DmitryTyazhlov/IR_iButton/hardware/PCB_3D_bottom_layer.png

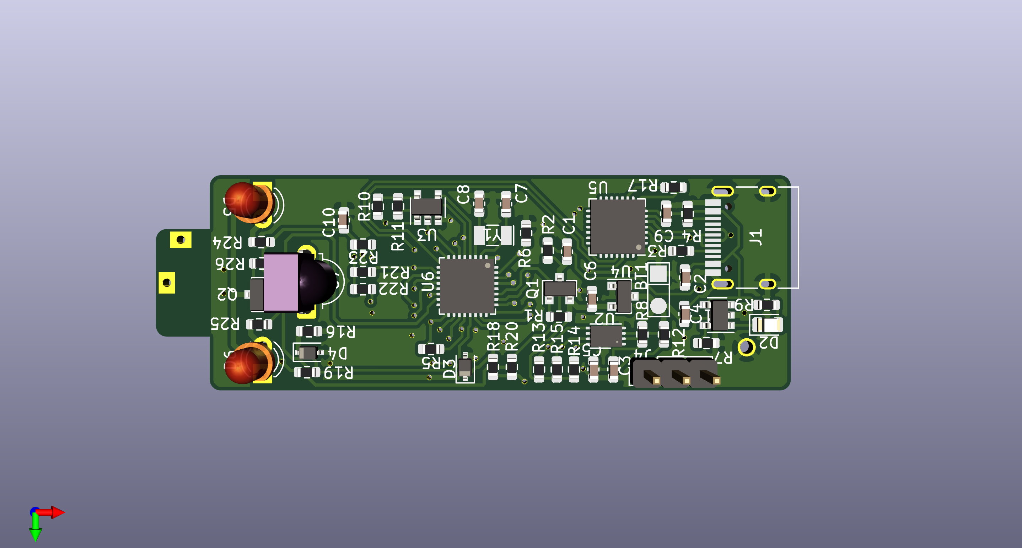
hardware/PCB_3D_bottom_layer.png
