DmitryTyazhlov/IR_iButton/hardware/PCB_3D_top_layer.png

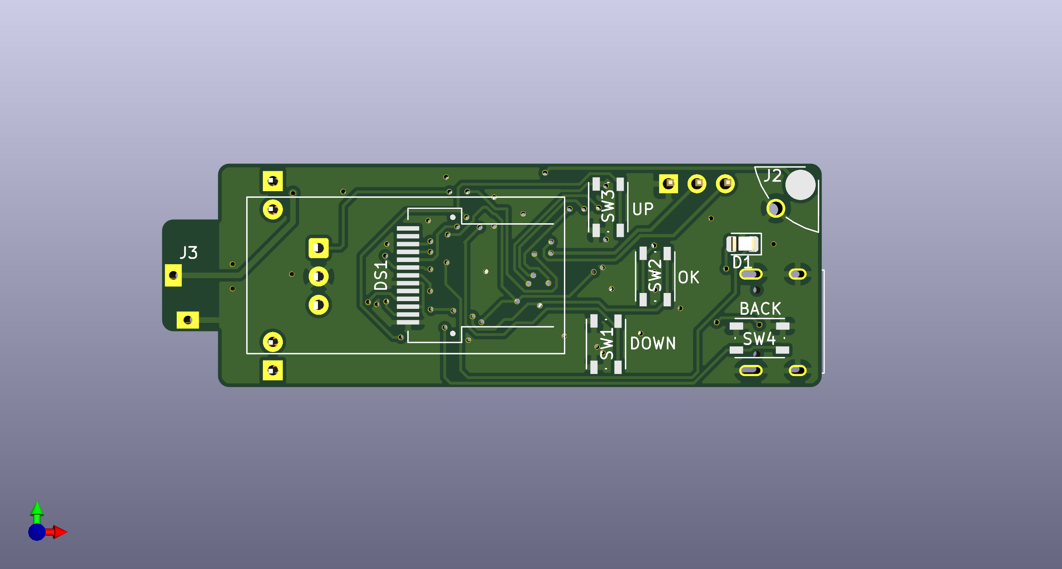
hardware/PCB_3D_top_layer.png
