DmitryTyazhlov/IR_iButton/docs/2021-11-05 23.26.21.jpg

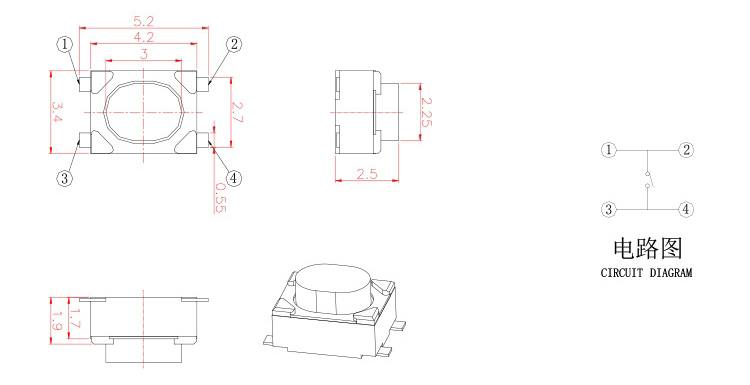
docs/2021-11-05 23.26.21.jpg
