DmitryTyazhlov/IR_iButton/docs/H74ff0cd74b204db1b7edd1876542bb8cC.png

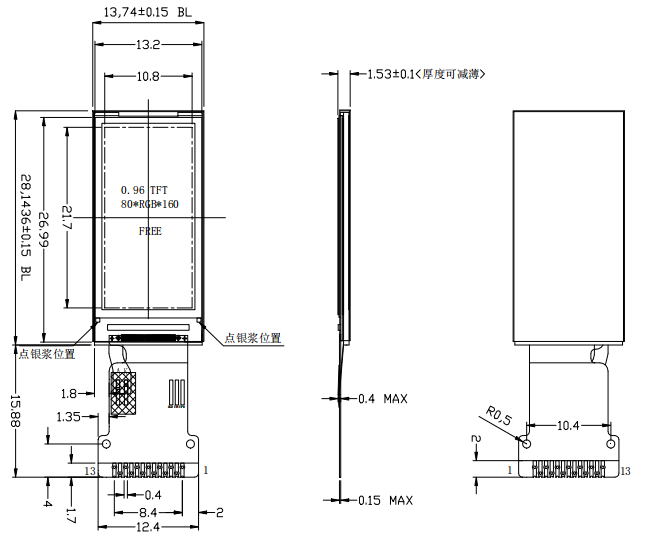
docs/H74ff0cd74b204db1b7edd1876542bb8cC.png
