DmitryTyazhlov/IR_iButton/docs/HTB19O_NNxjaK1RjSZKzq6xVwXXa3.webp

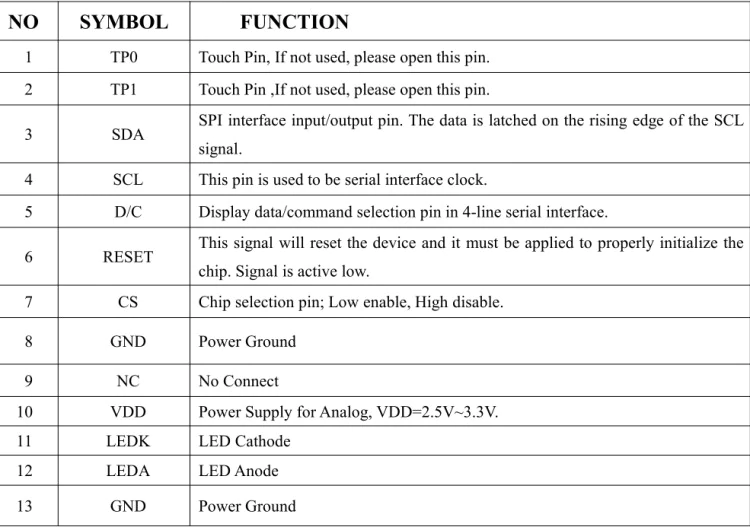
docs/HTB19O_NNxjaK1RjSZKzq6xVwXXa3.webp
