DmitryTyazhlov/IR_iButton/hardware/PCB_size.pdf

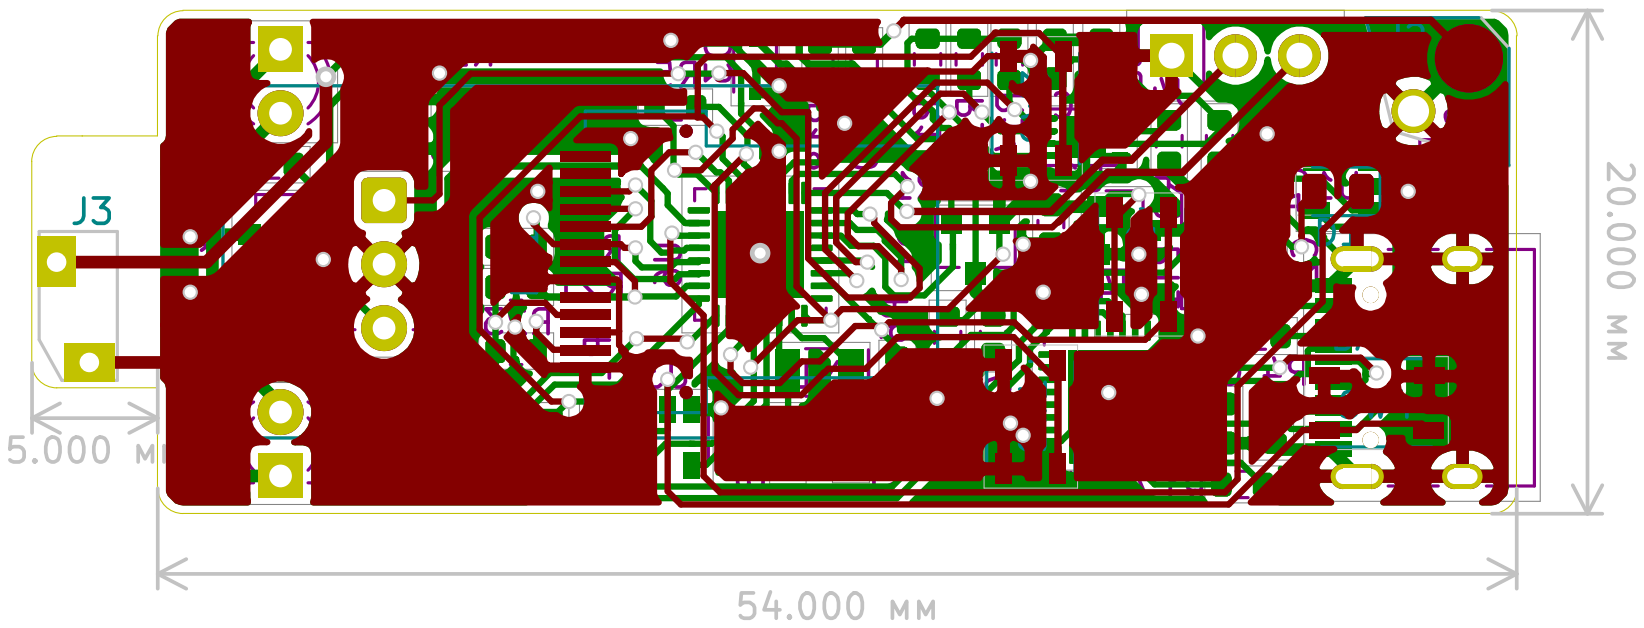
[picture p6: page 1]
