DmitryTyazhlov/IR_iButton/hardware/Scheme.pdf

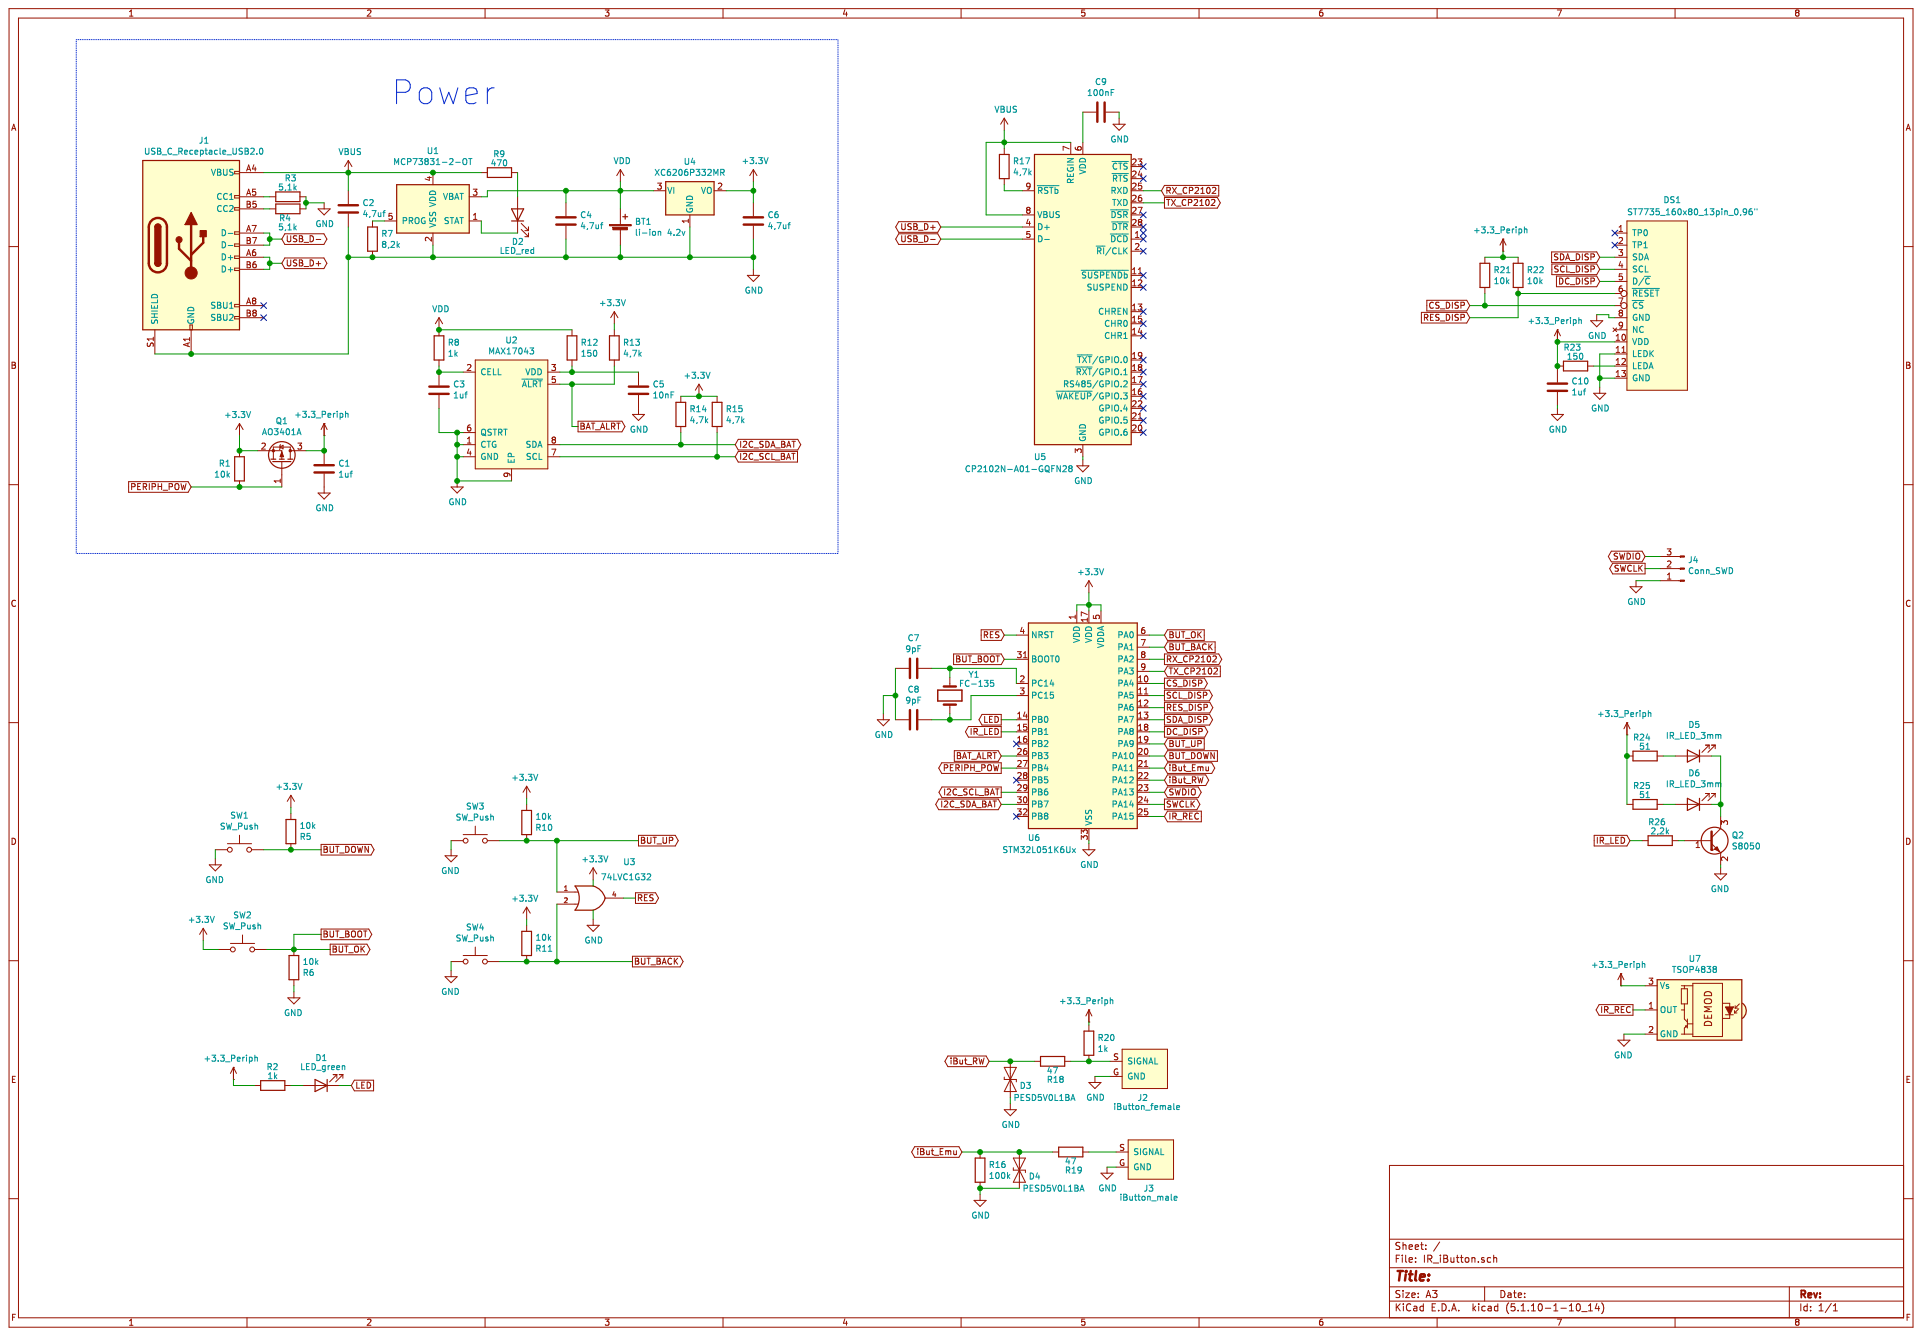
[picture p7: page 1]
