DmitryTyazhlov/IR_iButton/hardware/IR_iButton/IR_iButton.sch

## KiCad design hardware/IR_iButton/IR_iButton.sch (2021-12-14)

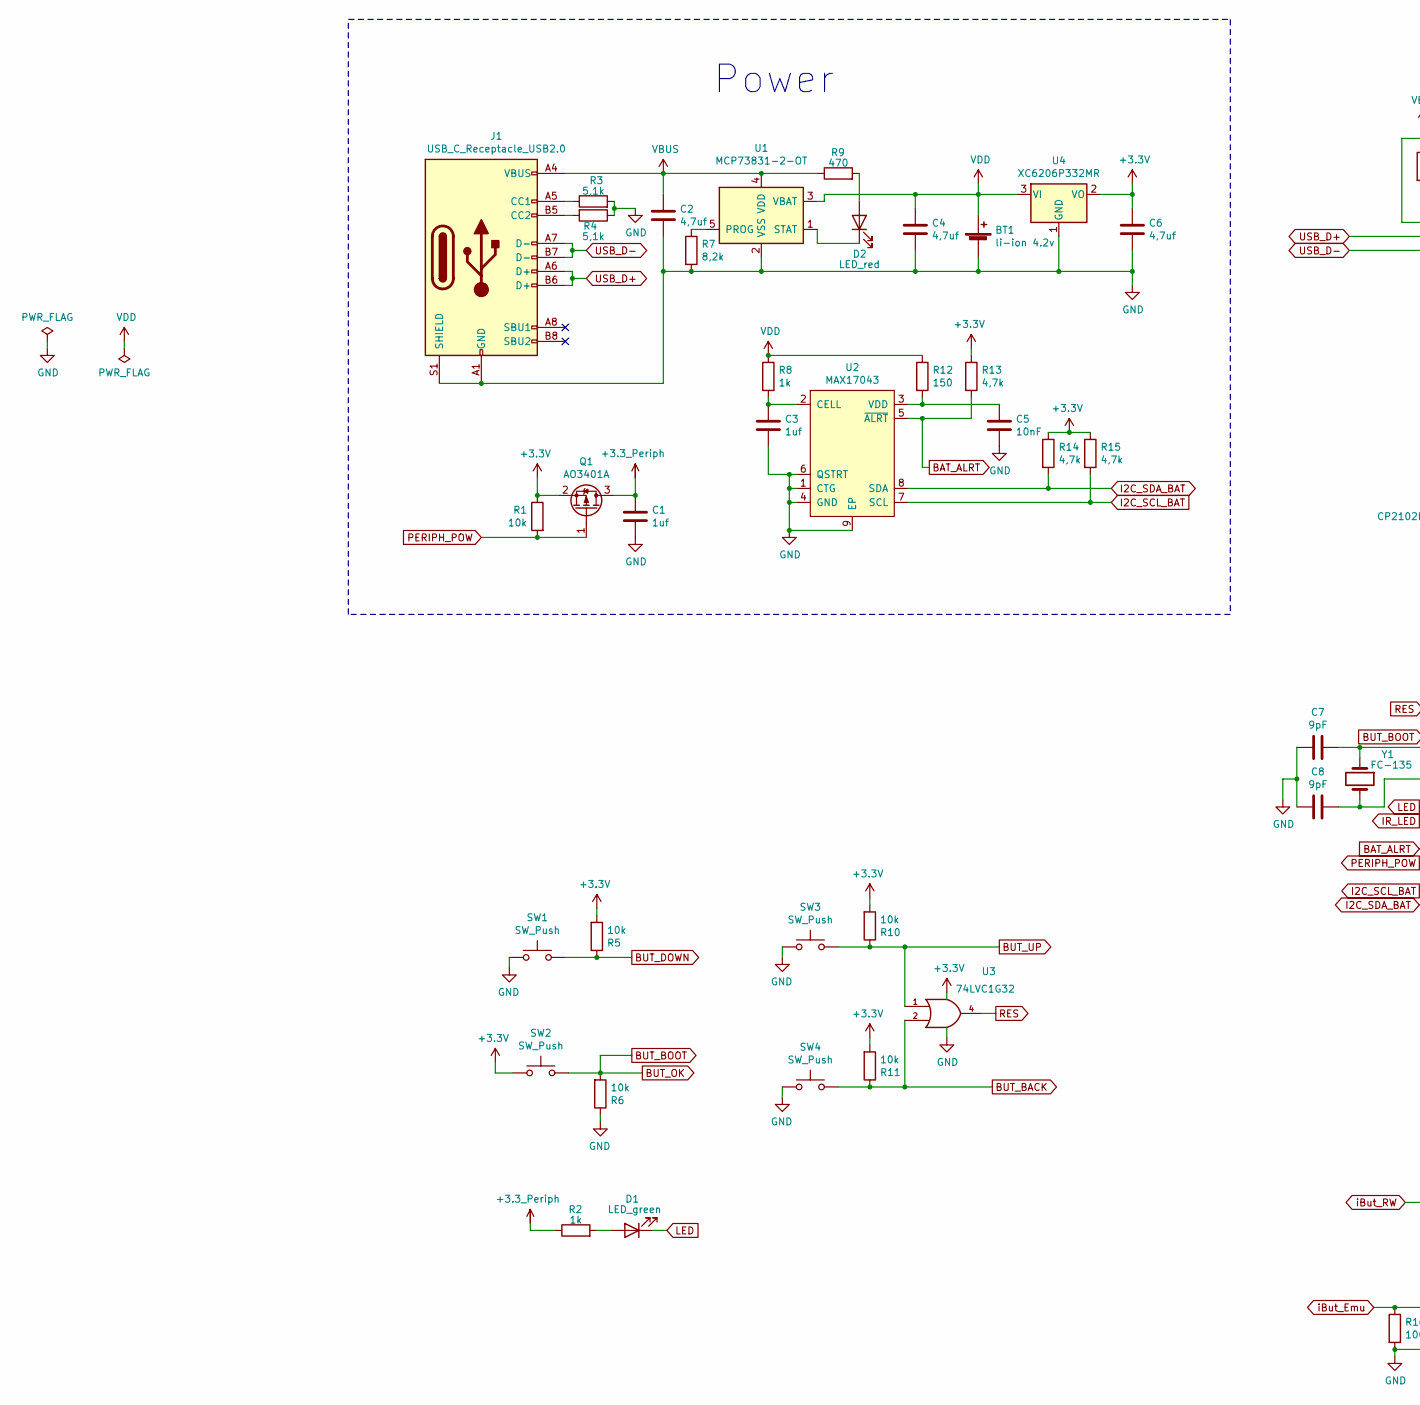
[picture p8: schematic IR_iButton.sch, part in row 2, column 1]

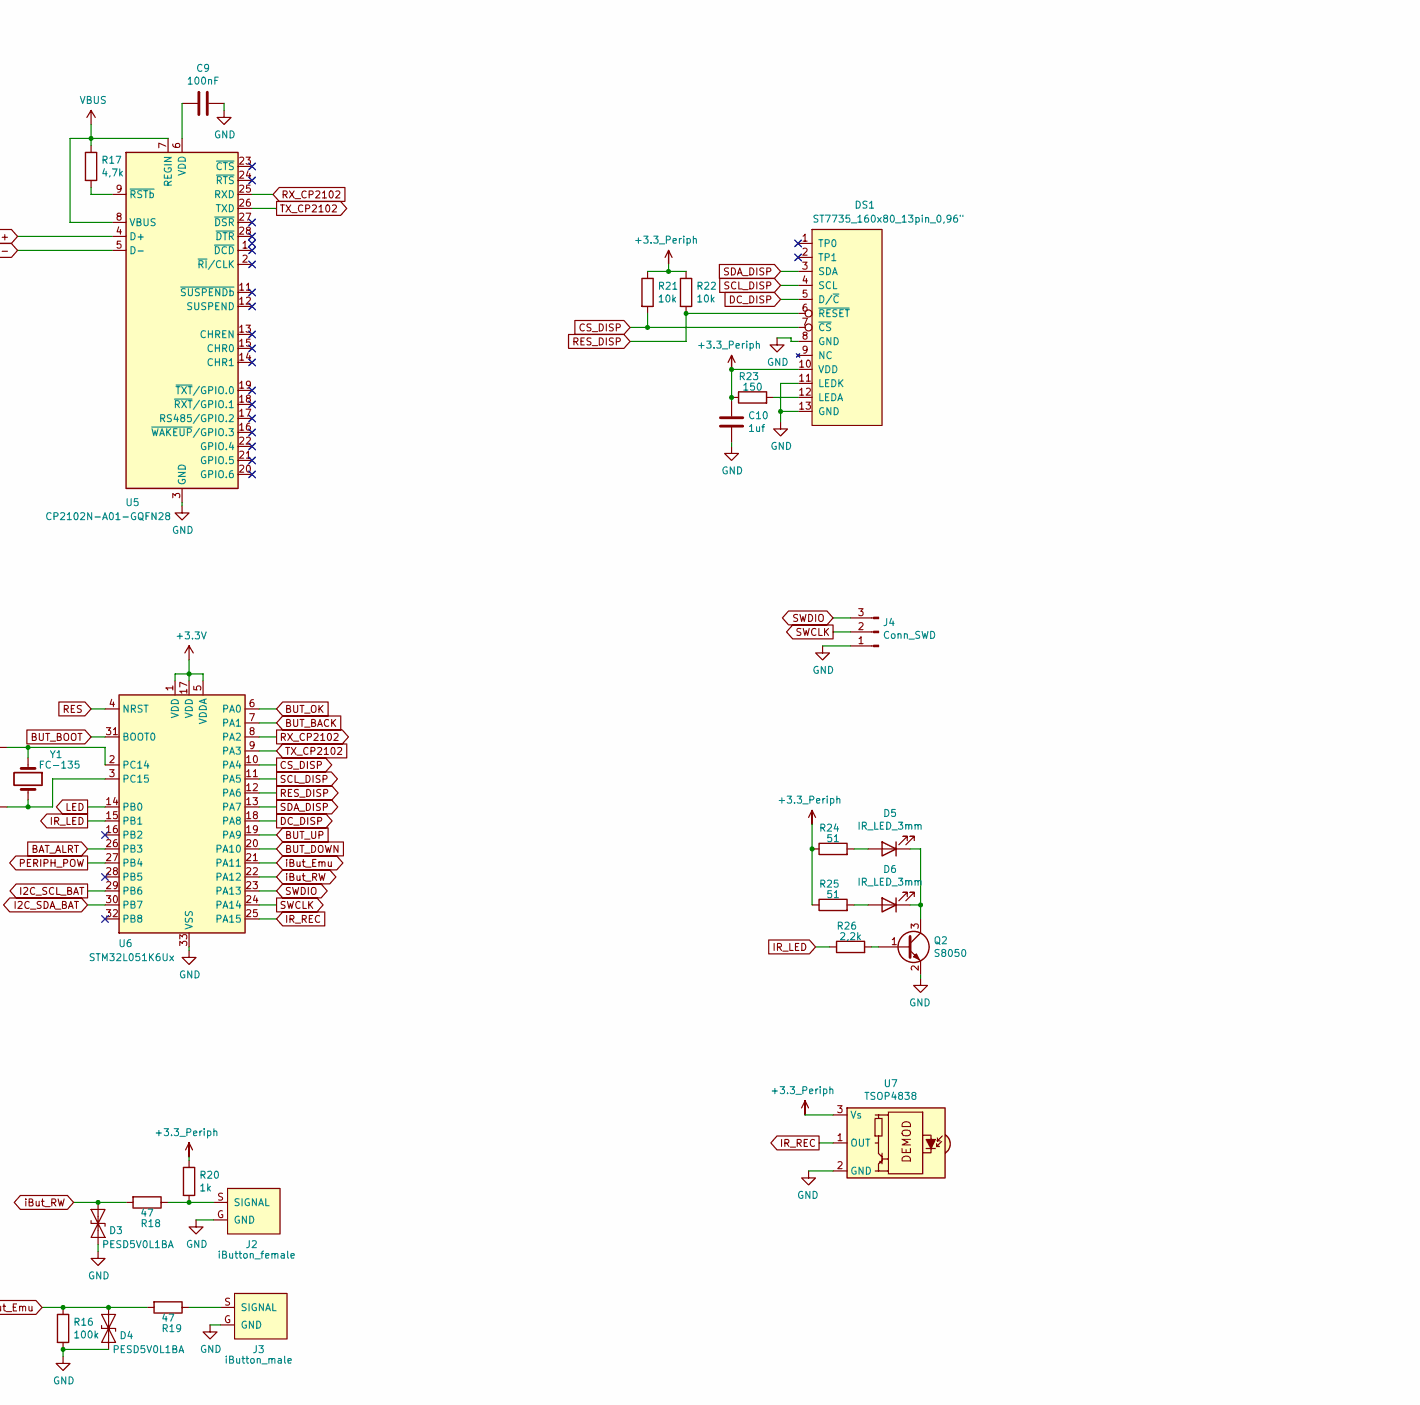
[picture p9: schematic IR_iButton.sch, part in row 2, column 2]

Parts:
BT1: li-ion 4.2v; Battery_smd
C1, C3, C10: 1uf; C_0603_1608Metric
C2, C4, C6: 4,7uf; C_0603_1608Metric
C5: 10nF; C_0603_1608Metric
C7, C8: 9pF; C_0603_1608Metric
C9: 100nF; C_0603_1608Metric
D1: LED_green; LED_0805_2012Metric
D2: LED_red; LED_0805_2012Metric
D3, D4: PESD5V0L1BA; D_SOD-323
D5, D6: IR_LED_3mm; LED_D3.0mm
DS1: ST7735_160x80_13pin_0,96\"; ST7735_160x80_0,96''_TOP
J1: USB_C_Receptacle_USB2.0; USB_C_Receptacle_HRO_TYPE-C-31-M-12
J2: iButton_female
J3: iButton_male
J4: Conn_SWD; PinHeader_1x03_P2.54mm_Vertical
Q1: AO3401A; SOT-23
Q2: S8050; SOT-23
R1, R5, R6, R10, R11, R21, R22: 10k; R_0603_1608Metric
R2, R8, R20: 1k; R_0603_1608Metric
R3, R4: 5,1k; R_0603_1608Metric
R7: 8,2k; R_0603_1608Metric
R9: 470; R_0603_1608Metric
R12, R23: 150; R_0603_1608Metric
R13, R14, R15, R17: 4,7k; R_0603_1608Metric
R16: 100k; R_0603_1608Metric
R18, R19: 47; R_0603_1608Metric
R24, R25: 51; R_0603_1608Metric
R26: 2,2k; R_0603_1608Metric
SW1, SW2, SW3, SW4: SW_Push; SW_Push_1P1T_NO_Vertical_Wuerth_434133025816
U1: MCP73831-2-OT; SOT-23-5
U2: MAX17043; TDFN-8-1EP_3x2mm_P0.5mm_EP1.80x1.65mm
U3: 74LVC1G32; SOT-23-5
U4: XC6206P332MR; SOT-23
U5: CP2102N-A01-GQFN28; QFN-28-1EP_5x5mm_P0.5mm_EP3.35x3.35mm
U6: STM32L051K6Ux; QFN-32-1EP_5x5mm_P0.5mm_EP3.45x3.45mm
U7: TSOP4838; Vishay_MINICAST-3Pin
Y1: FC-135; Crystal_SMD_EuroQuartz_EQ161-2Pin_3.2x1.5mm

Connections:
+3.3V: C6.2, Q1.2 (S), R1.1, R5.2, R10.2, R11.2, R13.1, R14.1, R15.1, SW2.1, U3.5 (VCC), U4.2 (VO), U6.1 (VDD), U6.5 (VDDA), U6.17 (VDD)
+3.3_Periph: C1.1, C10.2, DS1.10 (VDD), Q1.3 (D), R2.1, R20.1, R21.1, R22.1, R23.1, R24.1, R25.1, U7.3 (Vs)
BAT_ALRT: R13.2, U2.5 (~ALRT), U6.26 (PB3)
BUT_BACK: R11.1, SW4.2, U3.2, U6.7 (PA1)
BUT_BOOT: R6.2, SW2.2, U6.6 (PA0), U6.31 (BOOT0)
BUT_DOWN: R5.1, SW1.2, U6.20 (PA10)
BUT_UP: R10.1, SW3.2, U3.1, U6.19 (PA9)
CS_DISP: DS1.7 (~CS), R21.2, U6.10 (PA4)
DC_DISP: DS1.5 (D/~C), U6.18 (PA8)
GND: BT1.2 (-), C1.2, C2.1, C3.1, C4.1, C5.1, C6.1, C7.2, C8.2, C9.1, C10.1, D3.2 (A2), D4.2 (A2), DS1.8 (GND), DS1.11 (LEDK), DS1.13 (GND), J1.A1 (GND), J1.A12 (GND), J1.B1 (GND), J1.B12 (GND), J1.S1 (SHIELD), J2.G (GND), J3.G (GND), J4.1, Q2.2 (E), R3.2, R4.1, R6.1, R7.2, R16.2, SW1.1, SW3.1, SW4.1, U1.2 (VSS), U2.1 (CTG), U2.4 (GND), U2.6 (QSTRT), U2.9 (EP), U3.3 (GND), U4.1 (GND), U5.3 (GND), U5.29 (GND), U6.33 (VSS), U7.2 (GND)
I2C_SCL_BAT: R15.2, U2.7 (SCL), U6.29 (PB6)
I2C_SDA_BAT: R14.2, U2.8 (SDA), U6.30 (PB7)
IR_LED: R26.1, U6.15 (PB1)
IR_REC: U6.25 (PA15), U7.1 (OUT)
LED: D1.1 (K), U6.14 (PB0)
unnamed: C3.2, R8.2, U2.2 (CELL)
unnamed: C5.2, R12.2, U2.3 (VDD)
unnamed: C7.1, U6.2 (PC14), Y1.1
unnamed: C8.1, U6.3 (PC15), Y1.2
unnamed: C9.2, U5.6 (VDD)
unnamed: D1.2 (A), R2.2
unnamed: D2.1 (K), U1.1 (STAT)
unnamed: D2.2 (A), R9.2
unnamed: D5.1 (K), D6.1 (K), Q2.3 (C)
unnamed: D5.2 (A), R24.2
unnamed: D6.2 (A), R25.2
unnamed: DS1.12 (LEDA), R23.2
unnamed: J1.A5 (CC1), R3.1
unnamed: J1.B5 (CC2), R4.2
unnamed: J2.S (SIGNAL), R18.1, R20.2
unnamed: J3.S (SIGNAL), R19.1
unnamed: Q2.1 (B), R26.2
unnamed: R7.1, U1.5 (PROG)
unnamed: R17.2, U5.9 (~RSTb)
PERIPH_POW: Q1.1 (G), R1.2, U6.27 (PB4)
RES: U3.4, U6.4 (NRST)
RES_DISP: DS1.6 (~RESET), R22.2, U6.12 (PA6)
RX_CP2102: U5.25 (RXD), U6.8 (PA2)
SCL_DISP: DS1.4 (SCL), U6.11 (PA5)
SDA_DISP: DS1.3 (SDA), U6.13 (PA7)
SWCLK: J4.2, U6.24 (PA14)
SWDIO: J4.3, U6.23 (PA13)
TX_CP2102: U5.26 (TXD), U6.9 (PA3)
USB_D+: J1.A6 (D+), J1.B6 (D+), U5.4 (D+)
USB_D-: J1.A7 (D-), J1.B7 (D-), U5.5 (D-)
VBUS: C2.2, J1.A4 (VBUS), J1.A9 (VBUS), J1.B4 (VBUS), J1.B9 (VBUS), R9.1, R17.1, U1.4 (VDD), U5.7 (REGIN), U5.8 (VBUS)
VDD: BT1.1 (+), C4.2, R8.1, R12.1, U1.3 (VBAT), U4.3 (VI)
iBut_Emu: D4.1 (A1), R16.1, R19.2, U6.21 (PA11)
iBut_RW: D3.1 (A1), R18.2, U6.22 (PA12)

Notes on the sheet:
Power
