DmitryTyazhlov/IR_iButton/firmware/Core/Inc/main.h

#define BUT_OK_Pin GPIO_PIN_0
#define BUT_OK_GPIO_Port GPIOA
#define BUT_BACK_Pin GPIO_PIN_1
#define BUT_BACK_GPIO_Port GPIOA
#define DISP_CS_Pin GPIO_PIN_4
#define DISP_CS_GPIO_Port GPIOA
#define DISP_SCK_Pin GPIO_PIN_5
#define DISP_SCK_GPIO_Port GPIOA
#define DISP_RES_Pin GPIO_PIN_6
#define DISP_RES_GPIO_Port GPIOA
#define DISP_MOSI_Pin GPIO_PIN_7
#define DISP_MOSI_GPIO_Port GPIOA
#define LED_Pin GPIO_PIN_0
#define LED_GPIO_Port GPIOB
#define IR_LED_Pin GPIO_PIN_1
#define IR_LED_GPIO_Port GPIOB
#define DISP_DC_Pin GPIO_PIN_8
#define DISP_DC_GPIO_Port GPIOA
#define BUT_UP_Pin GPIO_PIN_9
#define BUT_UP_GPIO_Port GPIOA
#define BUT_DOWN_Pin GPIO_PIN_10
#define BUT_DOWN_GPIO_Port GPIOA
#define IBT_EMU_Pin GPIO_PIN_11
#define IBT_EMU_GPIO_Port GPIOA
#define IBT_RW_Pin GPIO_PIN_12
#define IBT_RW_GPIO_Port GPIOA
#define IR_REC_Pin GPIO_PIN_15
#define IR_REC_GPIO_Port GPIOA
#define BAT_ALRT_Pin GPIO_PIN_3
#define BAT_ALRT_GPIO_Port GPIOB
#define POW_PERIPH_Pin GPIO_PIN_4
#define POW_PERIPH_GPIO_Port GPIOB
#define BAT_SCL_Pin GPIO_PIN_6
#define BAT_SCL_GPIO_Port GPIOB
#define BAT_SDA_Pin GPIO_PIN_7
#define BAT_SDA_GPIO_Port GPIOB
#define COLOR_BACKGROUND 0x00
