DmitryTyazhlov/IR_iButton/(commit log)

2021-12-14 add scheme, pcb, gerber
    [IR_iButton-B_Cu.gbl, IR_iButton-B_Mask.gbs, IR_iButton-B_Paste.gbp, IR_iButton-B_SilkS.gbo, IR_iButton-Edge_Cuts.gm1, IR_iButton-F_Cu.gtl, IR_iButton-F_Mask.gts, IR_iButton-F_Paste.gtp]
2021-12-14 rename file
    [IR_iButton_list.csv]
2022-11-14 transmit spi on cmsis
2022-11-14 added interrupt every 30 ms
2026-10-25 Restructure firmware, add iButton, IR and battery gauge libs, rewrite menu
    - Move display driver to Lib/display, menu to App/, drop empty util files
    - Fix build: add missing sources to Makefile, enable HAL TIM, static inline
    helpers in the display driver, root Makefile forwarding to firmware/
    - Add buttons driver (debounce, queue, auto-repeat on TIM2 10 ms tick)
    - Add 1-Wire/iButton lib: DS1990A read with CRC and emulation
    - Add IR lib: 38 kHz transmit via TIM21, NEC/raw receive via EXTI, NEC decode
    - Add MAX17043 driver (I2C1) with bus diagnostics and Battery screen
    - Table-driven scrolling menu: iButton, IR, Battery, Settings
    - Sleep via Stop mode (OK wakes) instead of Standby: OK shares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
2026-10-25 Fix .gitignore and untrack macOS/KiCad junk
2026-10-25 Untrack KiCad fp-info-cache
